MartinKratkyProject/Diploma2024/DP/obrazky/optical_sorter.png

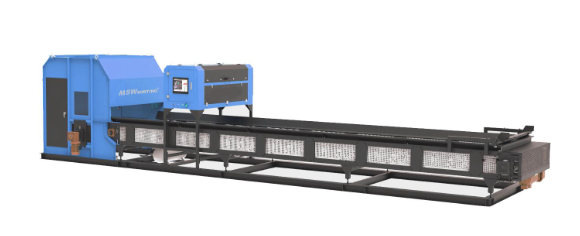
DP/obrazky/optical_sorter.png
