MartinKratkyProject/Diploma2024/model_linky/pas_navrh_spoja.png

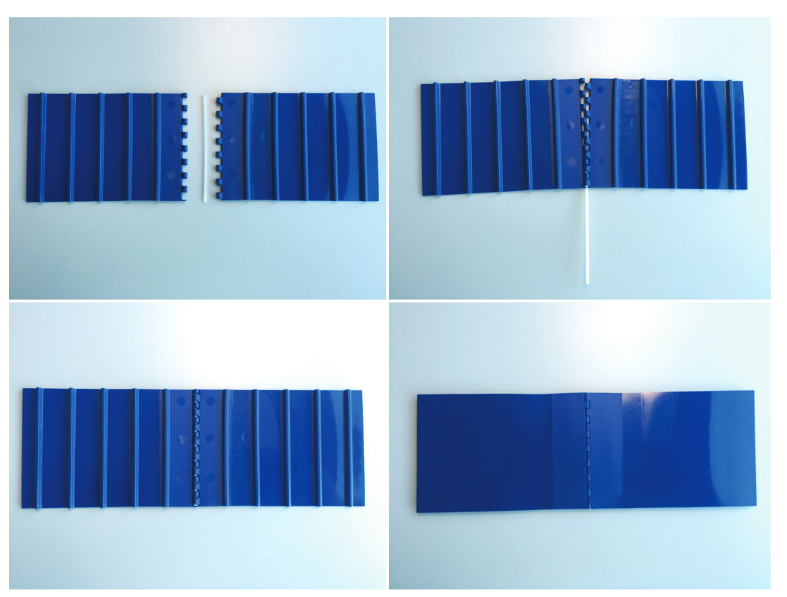
model_linky/pas_navrh_spoja.png
