MartinKratkyProject/Diploma2024/DP/obrazky/1712233651208.jpg

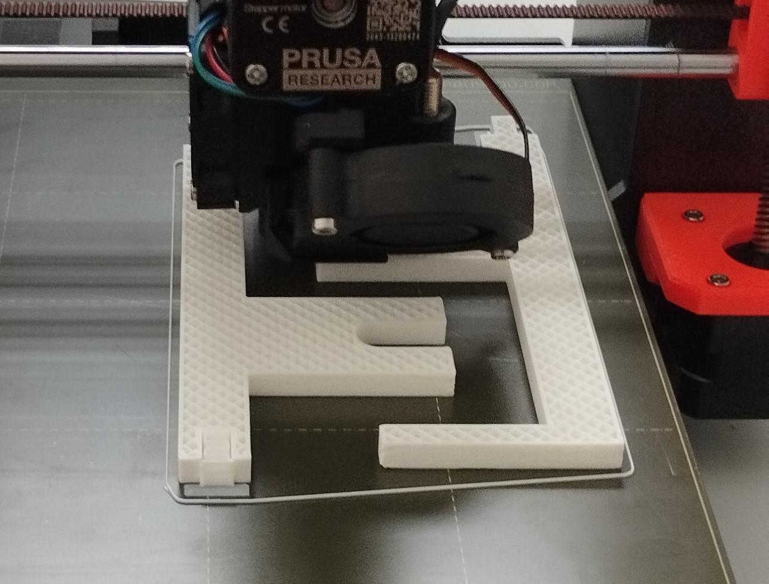
DP/obrazky/1712233651208.jpg
