MartinKratkyProject/Diploma2024/DP/obrazky/architektura_IoT.png

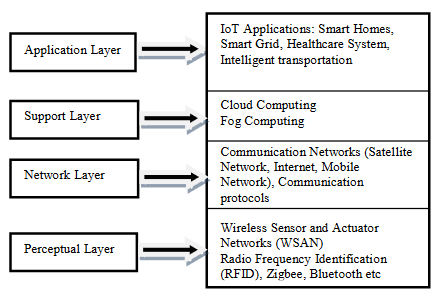
DP/obrazky/architektura_IoT.png
