MartinKratkyProject/Diploma2024/DP/obrazky/screen_appky.jpg

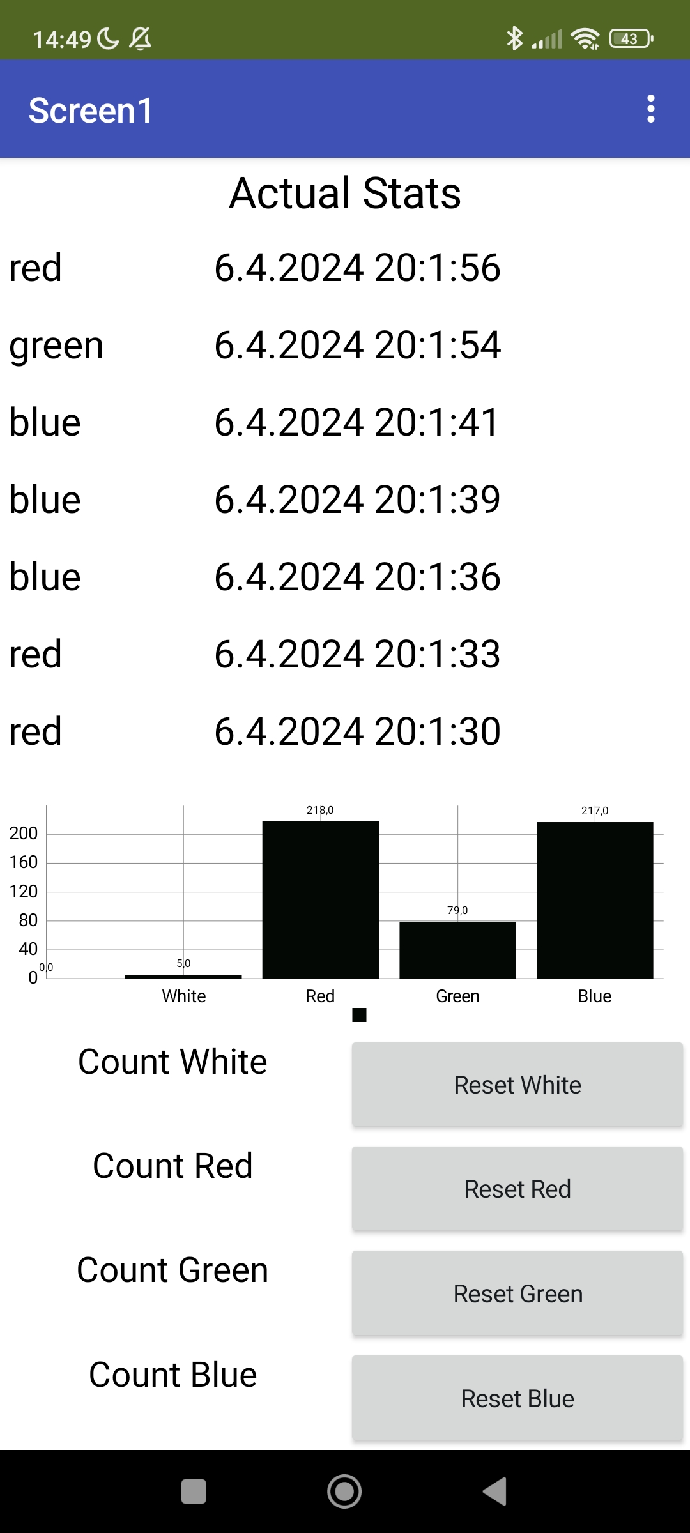
DP/obrazky/screen_appky.jpg
