MartinKratkyProject/Diploma2024/DP/obrazky/Snímka obrazovky 2024-04-12 154946.png

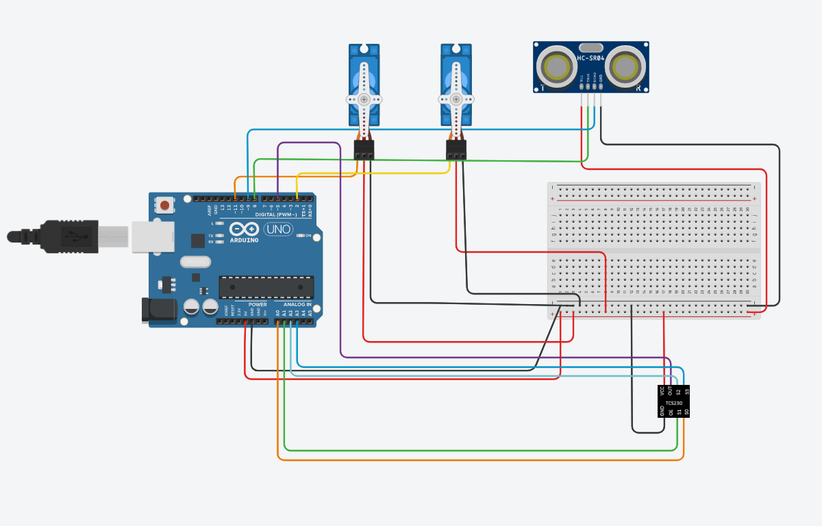
DP/obrazky/Snímka obrazovky 2024-04-12 154946.png
