MartinKratkyProject/Diploma2024/DP/obrazky/webGotText.png

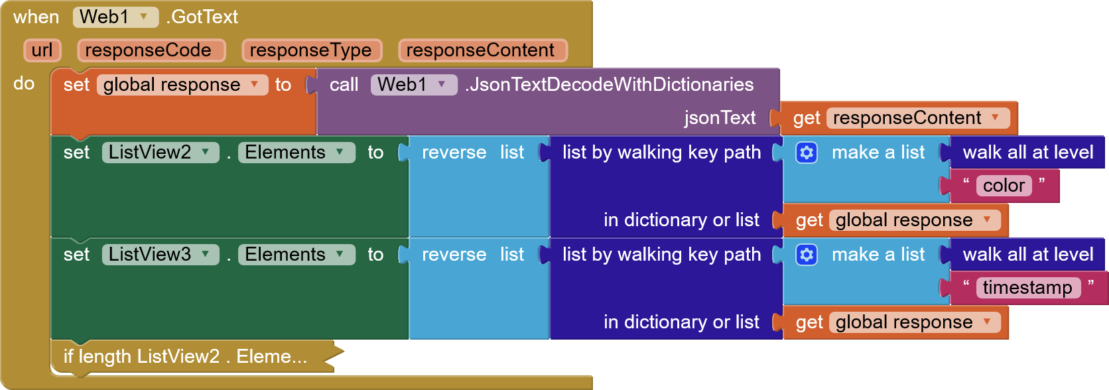
DP/obrazky/webGotText.png
