MartinKratkyProject/Diploma2024/DP/obrazky/webURL.png

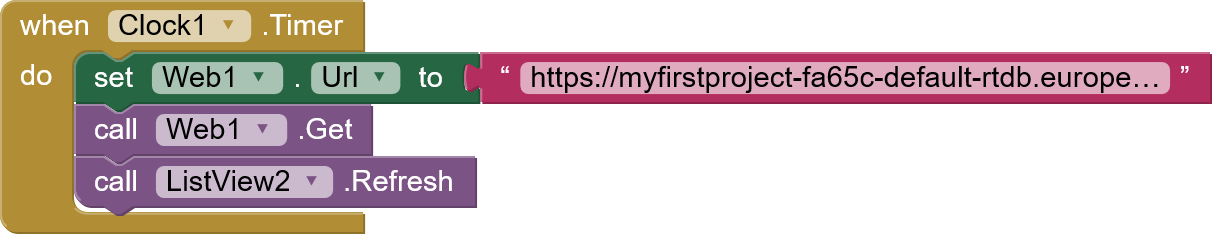
DP/obrazky/webURL.png
