MartinKratkyProject/Diploma2024/Screenshot 2024-04-18 at 12-02-07 zadanie-zp_94221.pdf.png

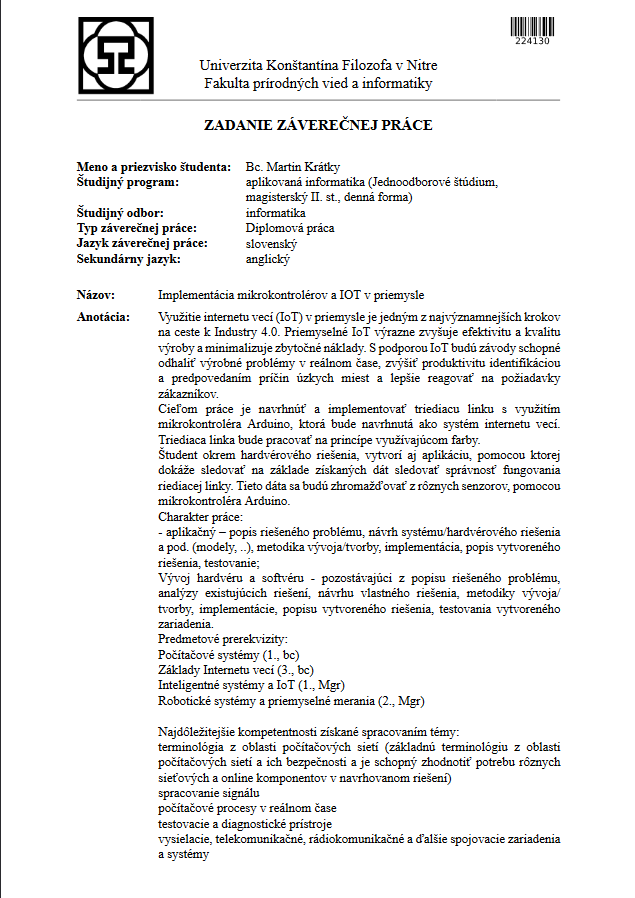
Screenshot 2024-04-18 at 12-02-07 zadanie-zp_94221.pdf.png
