MartinKratkyProject/Diploma2024/model_linky/hlavny_valec.stl

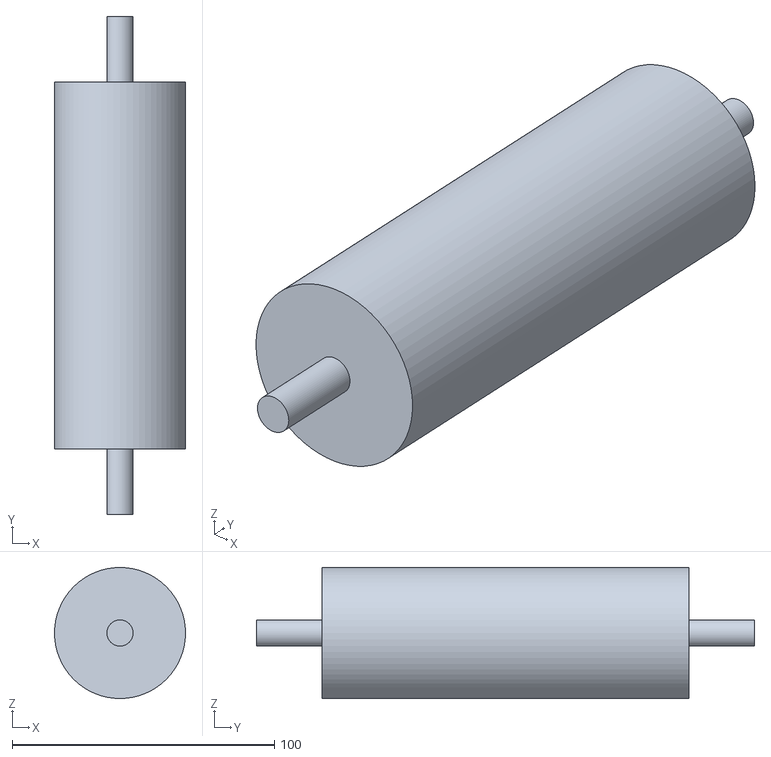
[picture p61: CAD file, 2024-02-08]
model_linky/hlavny_valec.stl
50.0 x 190.0 x 50.0
