MartinKratkyProject/Diploma2024/model_linky/vystupny_triedic.stl

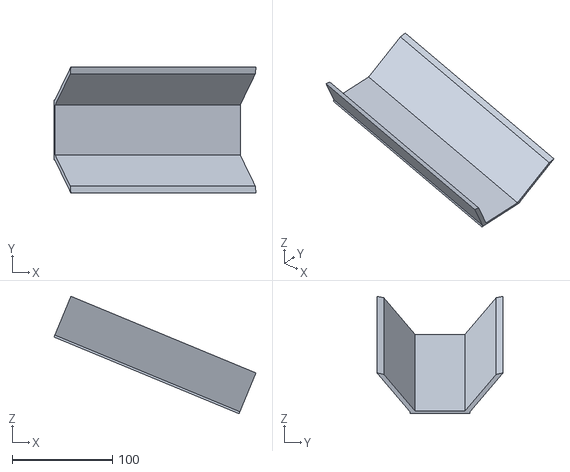
[picture p62: CAD file, 2024-02-08]
model_linky/vystupny_triedic.stl
201.6 x 126.0 x 117.2
