MartinKratkyProject/Diploma2024/model_linky/linka_vsetko.stl

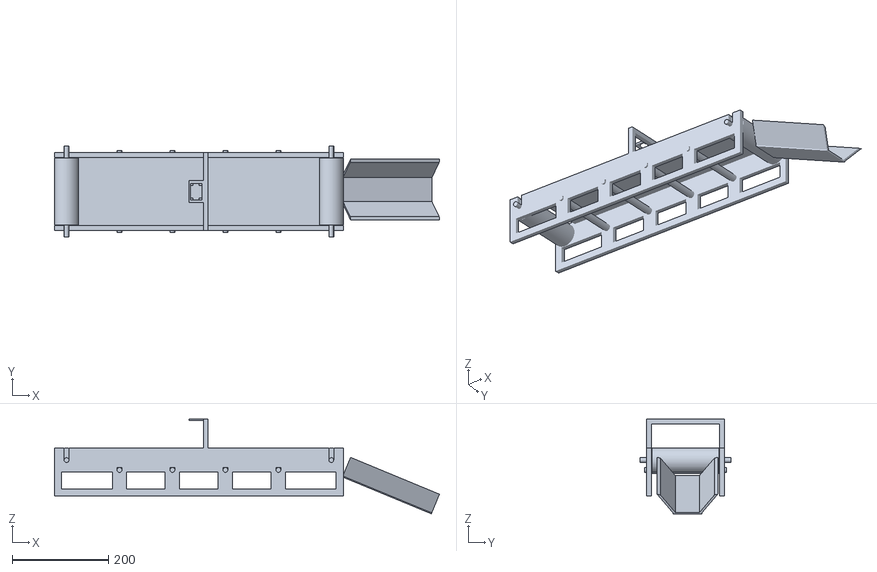
[picture p63: CAD file, 2024-02-08]
model_linky/linka_vsetko.stl
799.6 x 190.0 x 196.6
