MartinKratkyProject/Diploma2024/model_linky/podpora_linky.stl

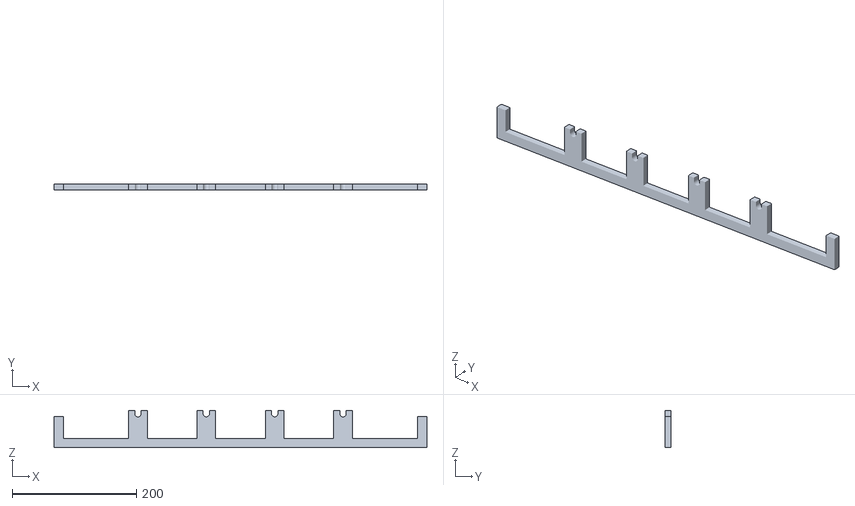
[picture p64: CAD file, 2024-02-08]
model_linky/podpora_linky.stl
600.0 x 10.0 x 60.0
