MartinKratkyProject/Diploma2024/model_linky/model_spojovaci_klin.stl

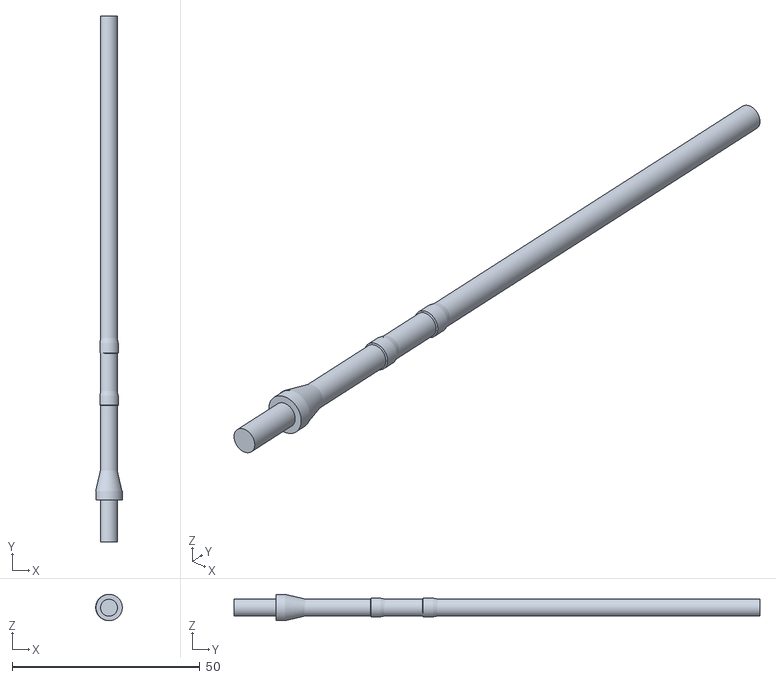
[picture p65: CAD file, 2024-02-08]
model_linky/model_spojovaci_klin.stl
7.10 x 140.0 x 7.00
