MartinKratkyProject/Diploma2024/model_linky/model_dopravny_pas.stl

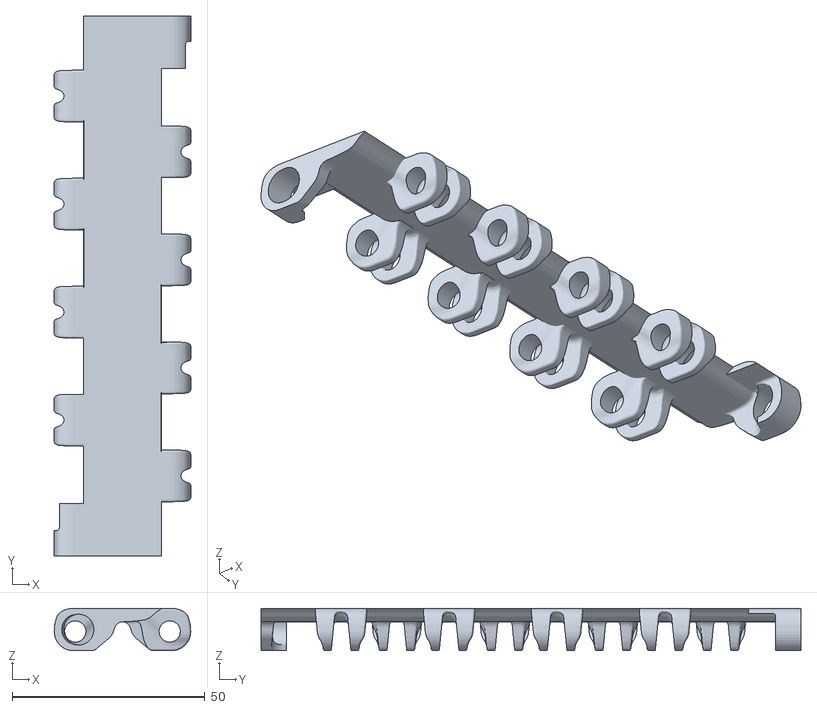
[picture p66: CAD file, 2024-02-08]
model_linky/model_dopravny_pas.stl
35.4 x 140.0 x 11.0
