MartinKratkyProject/Diploma2024/model_linky/podporny_valec.stl

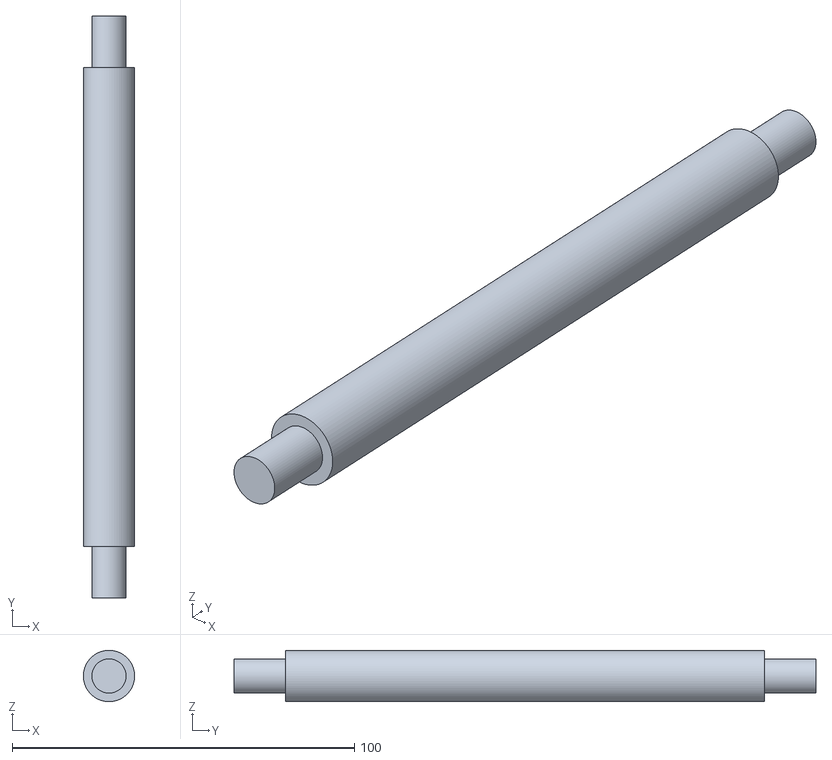
[picture p67: CAD file, 2024-02-08]
model_linky/podporny_valec.stl
15.0 x 170.0 x 15.0
