MartinKratkyProject/Diploma2024/model_linky/hlavna_cast_linky.stl

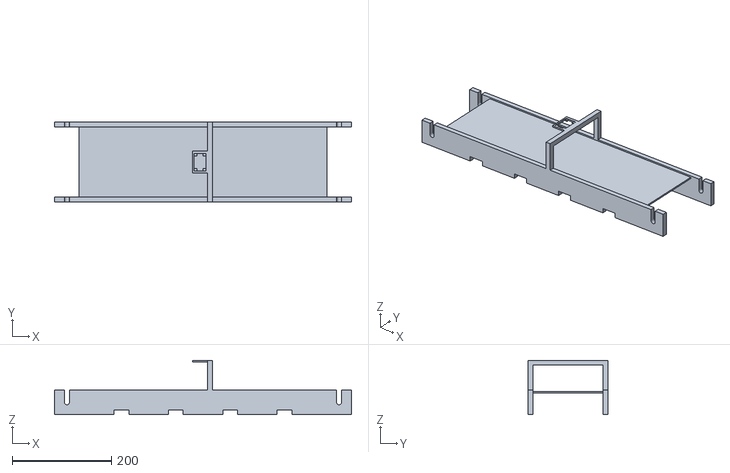
[picture p68: CAD file, 2024-02-08]
model_linky/hlavna_cast_linky.stl
600.0 x 162.0 x 110.0
